embeddedkink/lockbox/(list of files, cad)

Other CAD files:
lockbox_hardware/main.scad
