embeddedkink/lockbox/(commit log)

2021-11-28 initial content
    [box.FCStd, box.stl, cam-mk2.FCStd, cam-mk2.stl, lid.FCStd, lid.stl]
2021-12-14 reset lid design
    [lid.FCStd, lid.stl]
2021-12-14 heightened, tightened cam
    [cam-mk2.FCStd, cam-mk2.stl]
2022-03-21 latent changes
    [box.FCStd, box.stl]
2022-04-02 Fixed major oversight in lid design
    [lid.FCStd, lid.stl]
2022-06-11 set up structure
    [box.FCStd, box.stl, cam-mk2.FCStd, cam-mk2.stl, lid.FCStd, lid.stl, main.scad]
2022-06-17 first test fit print
    [main.scad]
2022-06-18 added model version tracking, box feature complete
    [main.scad]
2022-06-18 added logo
    [main.scad]
2022-06-18 changed order, fixed cam opening
    [main.scad]
2022-06-18 lid works
    [main.scad]
2022-06-25 fitting changes, added first version of cam
    [main.scad]
2022-06-25 minor changes
    [main.scad]
2022-06-25 additional tolerance changes
    [main.scad]
2022-07-09 added image generation, bugfixes
    [main.cpp]
2022-08-15 Updated logo
    [main.scad]
2022-08-15 adapted box for use with existing horns
    [main.scad]
2022-08-15 better box aesthetics
    [main.scad]
2022-08-17 minor fix
    [main.scad]
2022-08-17 cleaned up code, versioning, printability
    [main.scad]
2022-08-17 some more code cleanup
    [main.scad]
2022-08-17 smaller lid
    [main.scad]
2022-08-19 Code cleanup
    [main.scad]
2022-08-19 minor fixes
    [main.scad]
2022-08-19 changed tolerance
    [main.scad]
2022-08-19 added more room
    [main.scad]
2022-08-19 loosened tolerances
    [main.scad]
2022-08-22 very minor changes to model
    [main.scad]
2022-08-22 device_name did not refer to the name of the device
2022-08-28 Fixed servo wing pins
    [main.scad]
